mfacton/fsae-boards/aero-dev/aero-dev.kicad_pcb

## KiCad design aero-dev/aero-dev.kicad_pcb (2024-05-20)

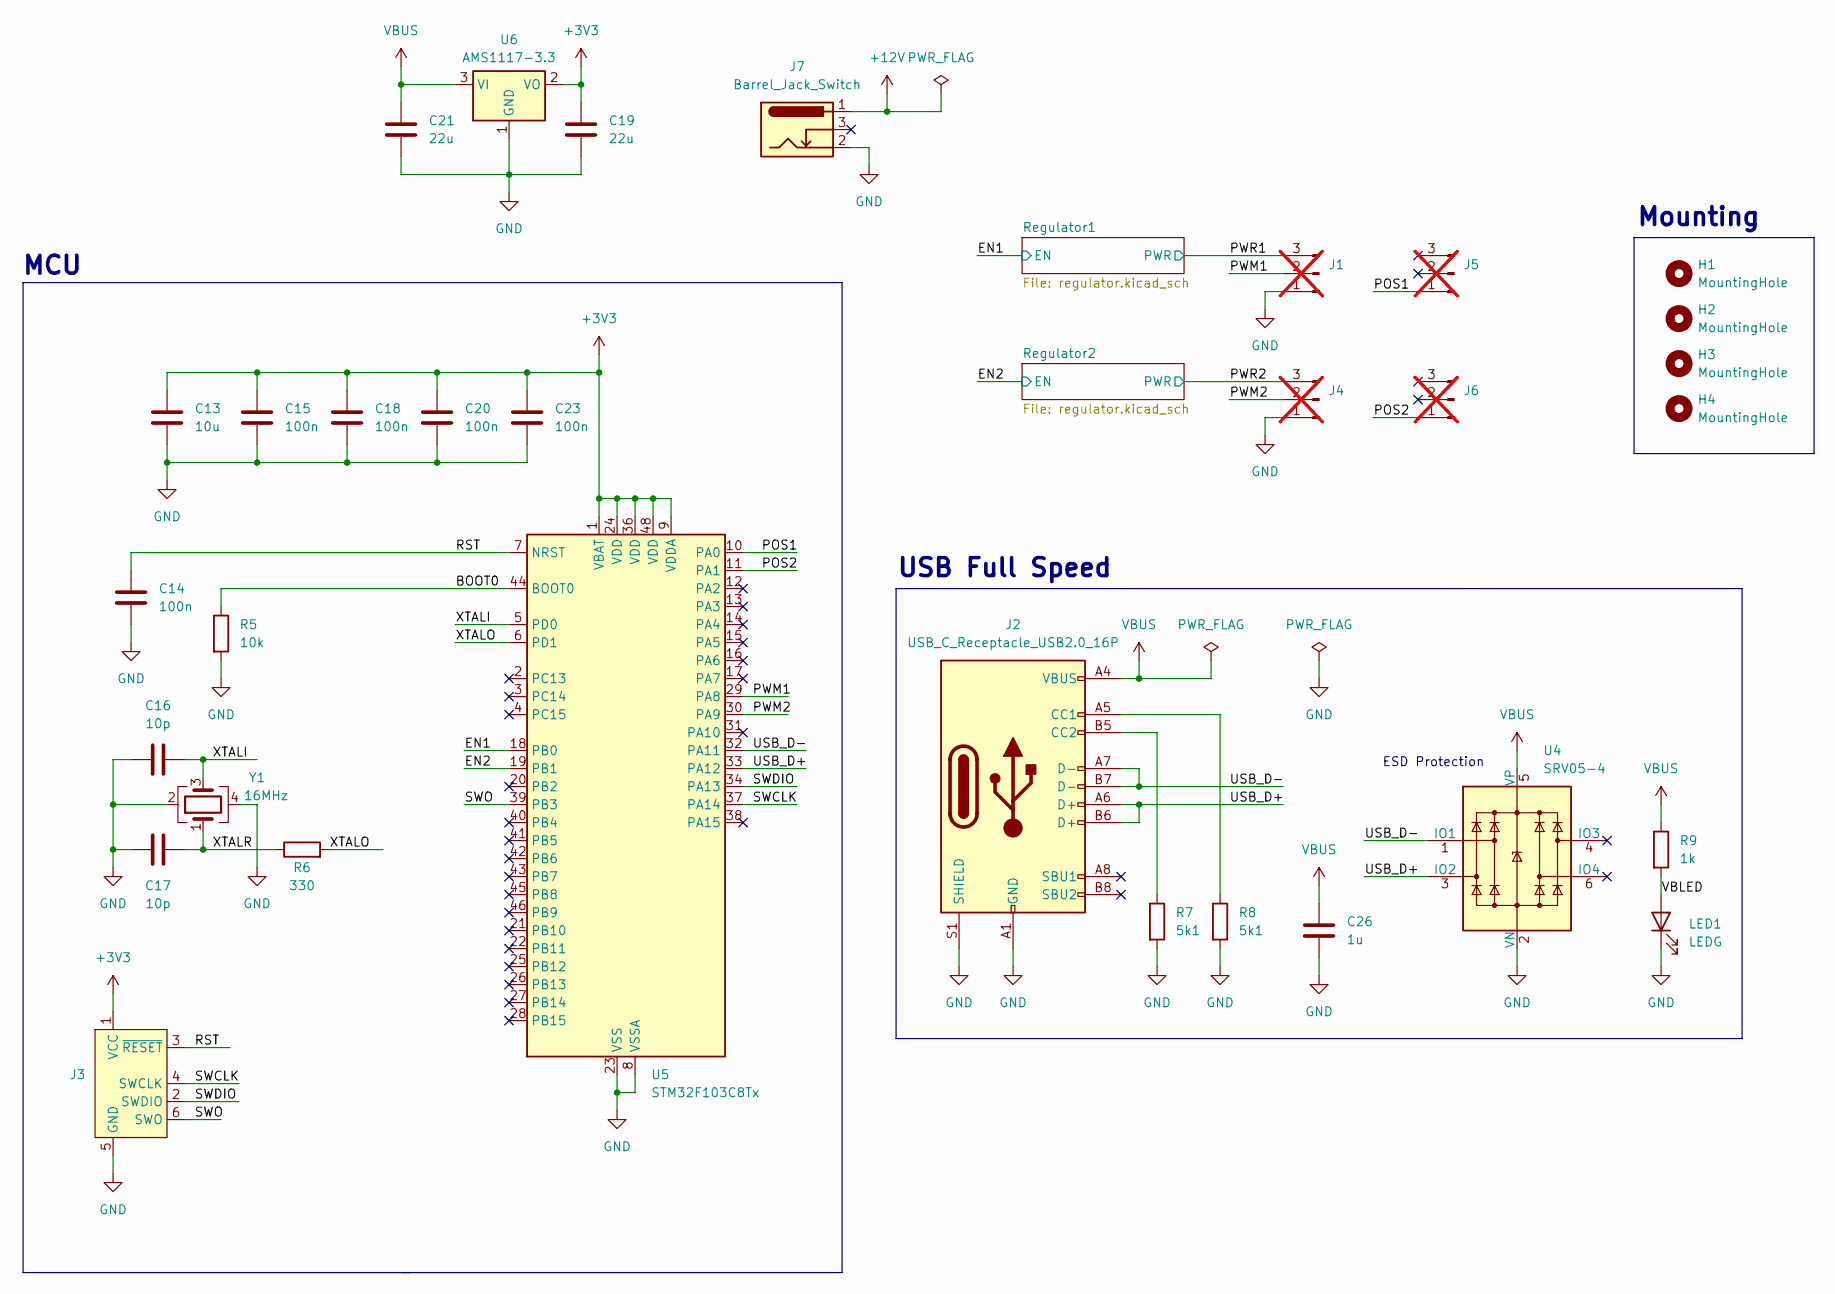
[picture p1: schematic aero-dev.kicad_sch]

Parts:
C13: 10u; C_0603_1608Metric
C14, C15, C18, C20, C23: 100n; C_0402_1005Metric
C16, C17: 10p; C_0402_1005Metric
C19: 22u; C_0603_1608Metric
C21: 22u; C_0805_2012Metric
C26: 1u; C_0402_1005Metric
H1, H2, H3, H4: MountingHole; MountingHole_3.2mm_M3
J1, J4, J5, J6: Conn_01x03_Pin; PinHeader_1x03_P2.54mm_Vertical; not fitted
J2: USB_C_Receptacle_USB2.0_16P; USB_C_Receptacle_GCT_USB4105-xx-A_16P_TopMnt_Horizontal; LCSC C165948
J3: Conn_ARM_SWD_TagConnect_TC2030-NL; Tag-Connect_TC2030-IDC-NL_2x03_P1.27mm_Vertical
J7: Barrel_Jack_Switch; BarrelJack_Horizontal; LCSC C319099
LED1: LEDG; LED_0603_1608Metric; LCSC C2986059
R5: 10k; R_0402_1005Metric
R6: 330; R_0402_1005Metric
R7, R8: 5k1; R_0402_1005Metric
R9: 1k; R_0402_1005Metric
U4: SRV05-4; SOT-23-6; LCSC C7420376
U5: STM32F103C8Tx; LQFP-48_7x7mm_P0.5mm
U6: AMS1117-3.3; SOT-223-3_TabPin2
Y1: 16MHz; Crystal_SMD_3225-4Pin_3.2x2.5mm

Connections:
+3V3: C13.1, C15.1, C18.1, C19.1, C20.1, C23.1, J3.1 (VCC), U5.1 (VBAT), U5.9 (VDDA), U5.24 (VDD), U5.36 (VDD), U5.48 (VDD), U6.2 (VO)
+12V: J7.1; also elsewhere on the board
/BOOT0: R5.1, U5.44 (BOOT0)
/EN1: U5.18 (PB0); also elsewhere on the board
/EN2: U5.19 (PB1); also elsewhere on the board
/POS1: J5.1, U5.10 (PA0)
/POS2: J6.1, U5.11 (PA1)
/PWM1: J1.2, U5.29 (PA8)
/PWM2: J4.2, U5.30 (PA9)
/PWR1: J1.3; also elsewhere on the board
/PWR2: J4.3; also elsewhere on the board
/RST: C14.1, J3.3 (~RESET), U5.7 (NRST)
/SWCLK: J3.4 (SWCLK), U5.37 (PA14)
/SWDIO: J3.2 (SWDIO), U5.34 (PA13)
/SWO: J3.6 (SWO), U5.39 (PB3)
/USB_D+: J2.A6 (D+), J2.B6 (D+), U4.3 (IO2), U5.33 (PA12)
/USB_D-: J2.A7 (D-), J2.B7 (D-), U4.1 (IO1), U5.32 (PA11)
/VBLED: LED1.2 (A), R9.2
/XTALI: C16.2, U5.5 (PD0), Y1.3
/XTALO: R6.2, U5.6 (PD1)
/XTALR: C17.2, R6.1, Y1.1
GND: C13.2, C14.2, C15.2, C16.1, C17.1, C18.2, C19.2, C20.2, C21.2, C23.2, C26.2, J1.1, J2.A1 (GND), J2.A12 (GND), J2.B1 (GND), J2.B12 (GND), J2.S1 (SHIELD), J3.5 (GND), J4.1, J7.2, LED1.1 (K), R5.2, R7.2, R8.2, U4.2 (VN), U5.8 (VSSA), U5.23 (VSS), U5.35 (VSS), U5.47 (VSS), U6.1 (GND), Y1.2, Y1.4; also elsewhere on the board
unnamed: J2.A5 (CC1), R8.1
unnamed: J2.B5 (CC2), R7.1
VBUS: C21.1, C26.1, J2.A4 (VBUS), J2.A9 (VBUS), J2.B4 (VBUS), J2.B9 (VBUS), R9.1, U4.5 (VP), U6.3 (VI)

Notes on the sheet:
Mounting
ESD Protection
MCU
USB Full Speed

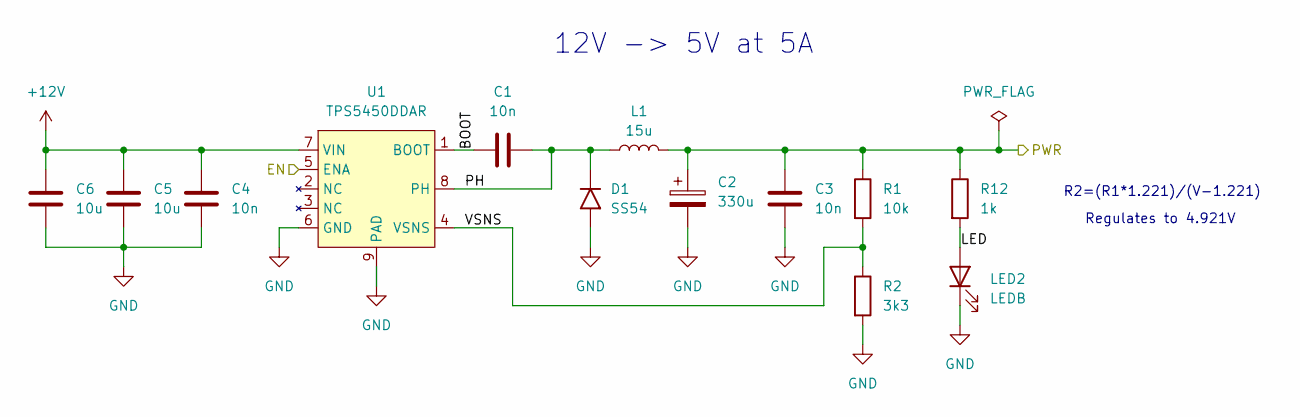
[picture p2: schematic regulator.kicad_sch]

Parts:
C1, C3, C4: 10n; C_0402_1005Metric
C2: 330u; CP_Elec_10x10.5; LCSC C280411
C5, C6: 10u; C_1206_3216Metric; LCSC C13585
D1: SS54; D_SMA
L1: 15u; L_12x12mm_H4.5mm; LCSC C149596
LED2: LEDB; LED_0603_1608Metric; LCSC C2986058
R1: 10k; R_0603_1608Metric_Pad0.98x0.95mm_HandSolder
R2: 3k3; R_0603_1608Metric_Pad0.98x0.95mm_HandSolder
R12: 1k; R_0402_1005Metric
U1: TPS5450DDAR; Texas_R-PDSO-G8_EP2.95x4.9mm_Mask2.4x3.1mm; LCSC C114425

Connections:
+12V: C4.1, C5.1, C6.1, U1.7 (VIN); also elsewhere on the board
/EN1: U1.5 (ENA); also elsewhere on the board
/PWR1: C2.1, C3.1, L1.2, R1.1, R12.1; also elsewhere on the board
/Regulator1/BOOT: C1.2, U1.1 (BOOT)
/Regulator1/LED: LED2.2 (A), R12.2
/Regulator1/PH: C1.1, D1.1 (K), L1.1, U1.8 (PH)
/Regulator1/VSNS: R1.2, R2.1, U1.4 (VSNS)
GND: C2.2, C3.2, C4.2, C5.2, C6.2, D1.2 (A), LED2.1 (K), R2.2, U1.6 (GND), U1.9 (PAD); also elsewhere on the board

Parts of its further copies:
C7, C8: 10u; C_1206_3216Metric; LCSC C13585
C9, C10, C12: 10n; C_0402_1005Metric
C11: 330u; CP_Elec_10x10.5; LCSC C280411
D2: SS54; D_SMA
L2: 15u; L_12x12mm_H4.5mm; LCSC C149596
LED3: LEDB; LED_0603_1608Metric; LCSC C2986058
R3: 10k; R_0603_1608Metric_Pad0.98x0.95mm_HandSolder
R4: 3k3; R_0603_1608Metric_Pad0.98x0.95mm_HandSolder
R13: 1k; R_0402_1005Metric
U2: TPS5450DDAR; Texas_R-PDSO-G8_EP2.95x4.9mm_Mask2.4x3.1mm; LCSC C114425

Connections of its further copies:
+12V: C7.1, C8.1, C9.1, U2.7 (VIN); also elsewhere on the board
/EN2: U2.5 (ENA); also elsewhere on the board
/PWR2: C11.1, C12.1, L2.2, R3.1, R13.1; also elsewhere on the board
/Regulator2/BOOT: C10.2, U2.1 (BOOT)
/Regulator2/LED: LED3.2 (A), R13.2
/Regulator2/PH: C10.1, D2.1 (K), L2.1, U2.8 (PH)
/Regulator2/VSNS: R3.2, R4.1, U2.4 (VSNS)
GND: C7.2, C8.2, C9.2, C11.2, C12.2, D2.2 (A), LED3.1 (K), R4.2, U2.6 (GND), U2.9 (PAD); also elsewhere on the board

Notes on the sheet:
R2=(R1*1.221)/(V-1.221)
Regulates to 4.921V
12V -> 5V at 5A

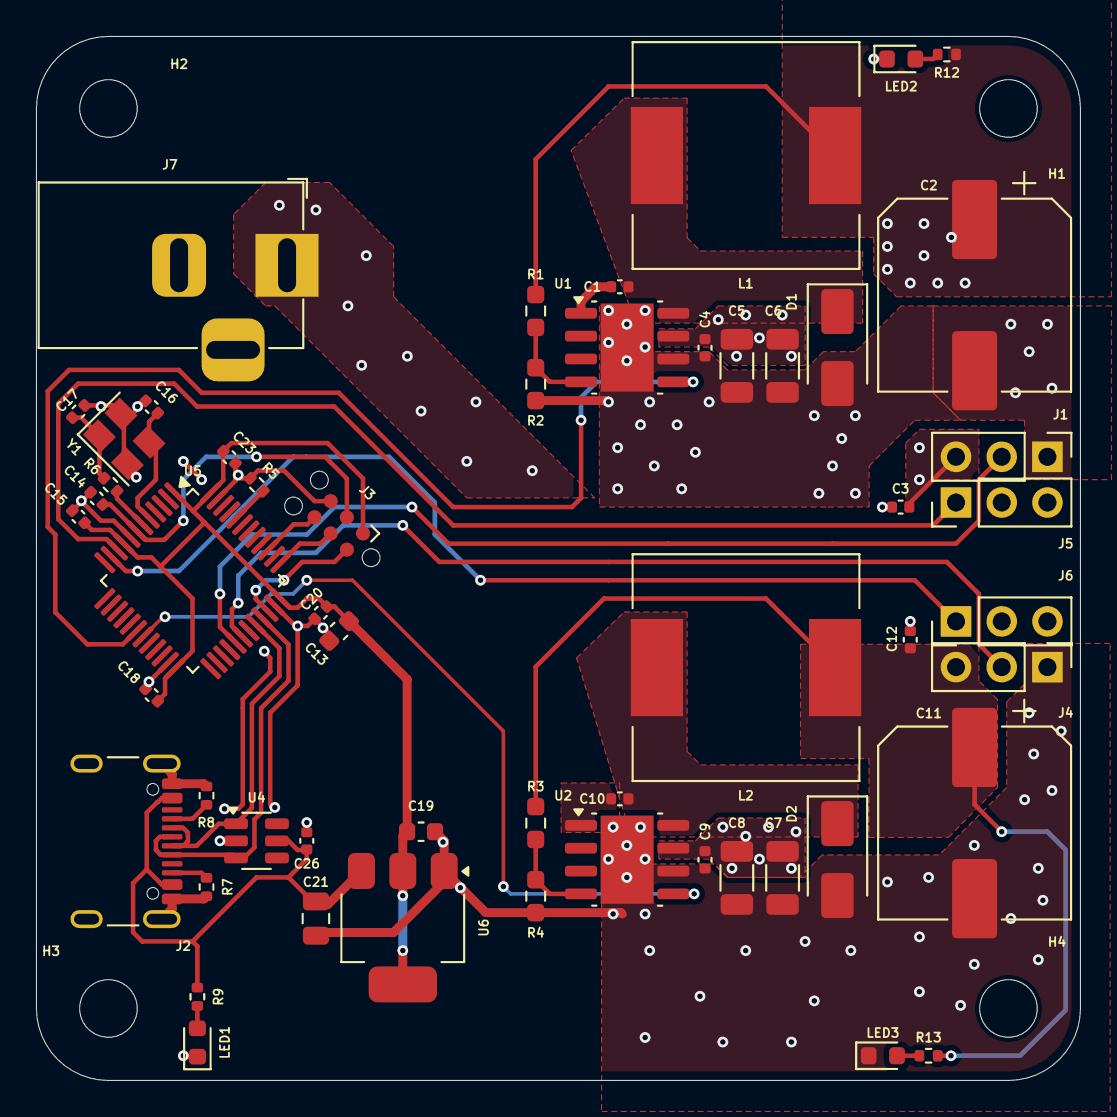
[picture p3: board aero-dev.kicad_pcb from above]

Board: 2 copper layers, 58.0 x 58.0 mm, 58 parts (0 on the bottom side), 33 nets.
