mfacton/fsae-boards/(commit log)

2024-05-19 Remove kicad ignores to fix later
2024-05-19 Update .gitignore for kicad files
2024-05-19 Finish schematic, positions and zones
    [aero-dev.kicad_pcb, aero-dev.kicad_sch, regulator.kicad_sch]
2024-05-20 Make initial production file
    [aero-dev.kicad_pcb, bom.csv, designators.csv, positions.csv]
2024-05-20 Finalize production files and minor edits
    [aero-dev.kicad_pcb, aero-dev.kicad_sch, bom.csv, positions.csv, regulator.kicad_sch]
